RhinoDevel/cbmtapepi/docs/CBM Tape Pi - Raspberry Pi GPIO connections.png

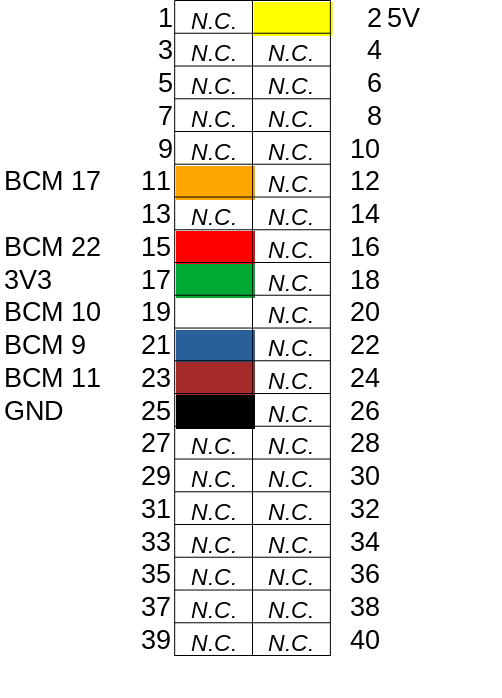
docs/CBM Tape Pi - Raspberry Pi GPIO connections.png
