RhinoDevel/cbmtapepi/docs/scope/CBM to Pi - MOTOR - fall (lower than 0_9V at Pi after 40us).png

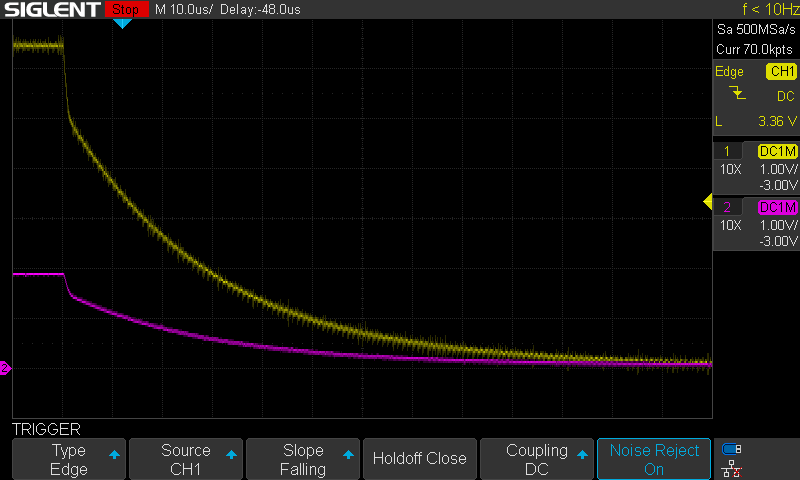
docs/scope/CBM to Pi - MOTOR - fall (lower than 0_9V at Pi after 40us).png
