RhinoDevel/cbmtapepi/docs/scope/CBM to Pi - MOTOR - rise (higher than 1_6V at Pi after 20us).png

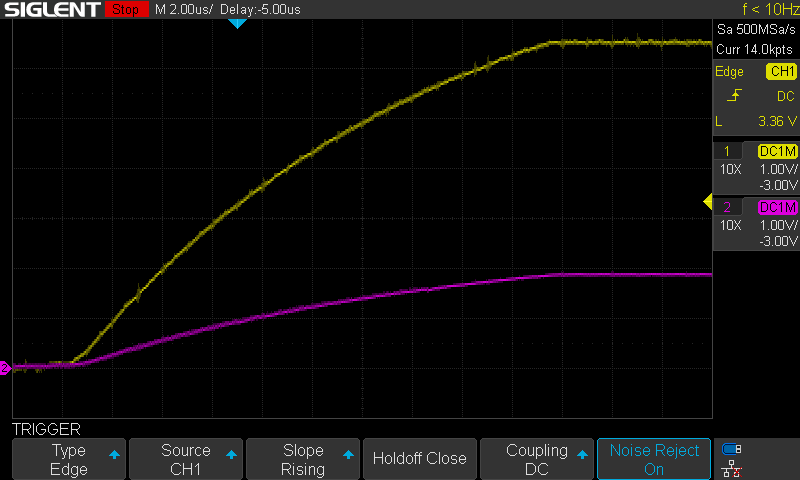
docs/scope/CBM to Pi - MOTOR - rise (higher than 1_6V at Pi after 20us).png
