RhinoDevel/cbmtapepi/docs/scope/CBM to Pi - WRITE - fall at CBM (higher than 1_6V at Pi after 2_5us.png

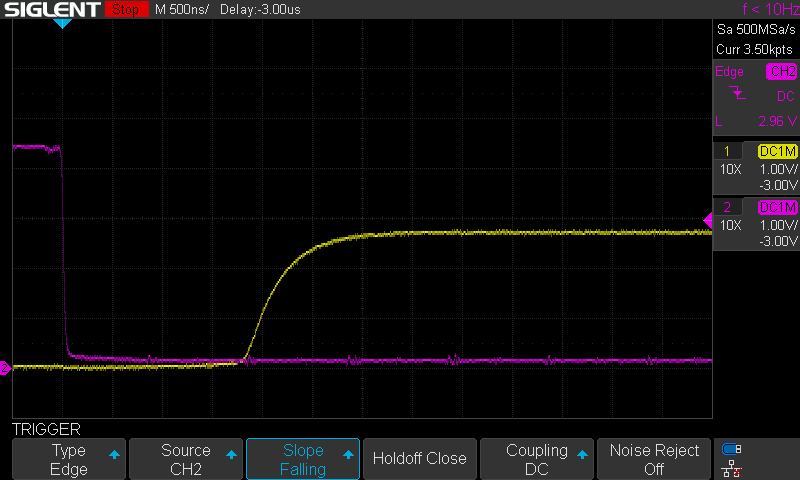
docs/scope/CBM to Pi - WRITE - fall at CBM (higher than 1_6V at Pi after 2_5us.png
