RhinoDevel/cbmtapepi/docs/scope/CBM to Pi - WRITE - rise at CBM (lower than 0_9V at Pi after 1us).png

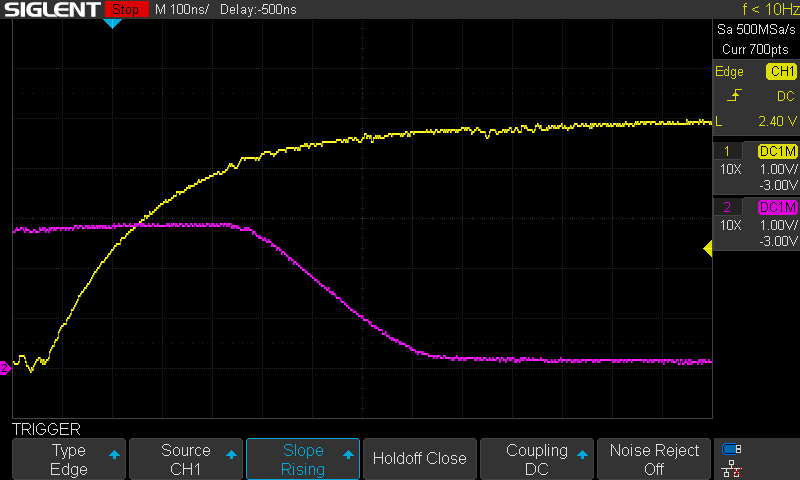
docs/scope/CBM to Pi - WRITE - rise at CBM (lower than 0_9V at Pi after 1us).png
