RhinoDevel/cbmtapepi/docs/scope/Pi to CBM - READ - rise at Pi (lower than 0_4V at CBM after 0_2us).png

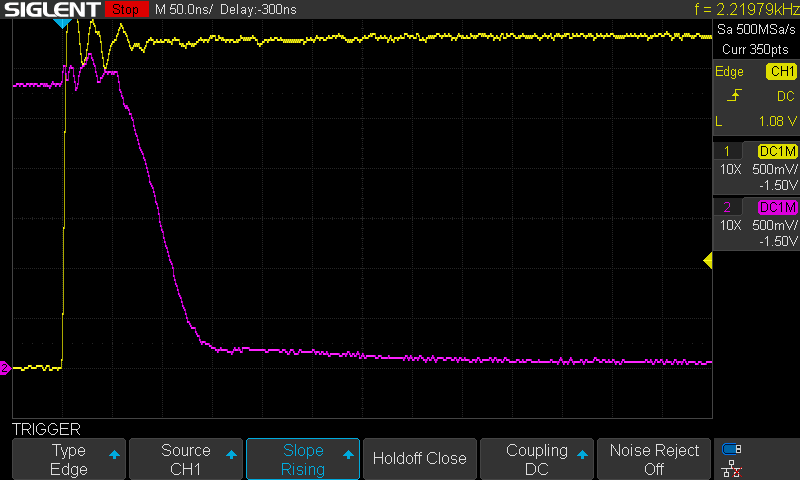
docs/scope/Pi to CBM - READ - rise at Pi (lower than 0_4V at CBM after 0_2us).png
