RhinoDevel/cbmtapepi/docs/scope/Pi to CBM - SENSE - fall at Pi (higher than 2V at CBM after 3us).png

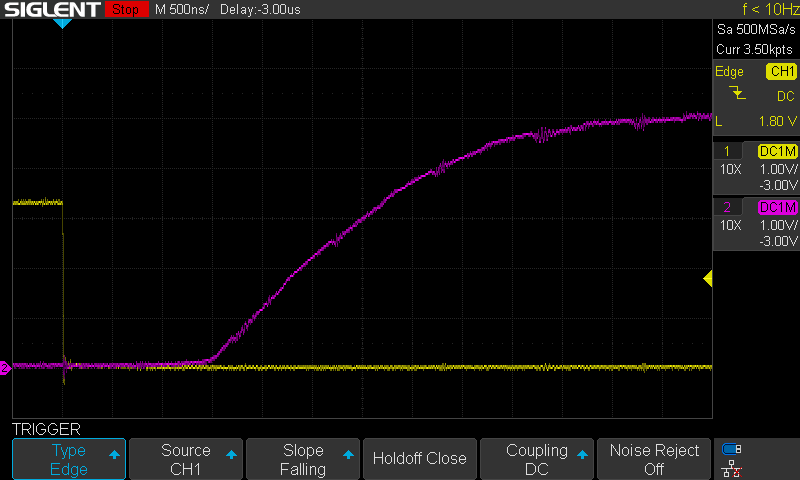
docs/scope/Pi to CBM - SENSE - fall at Pi (higher than 2V at CBM after 3us).png
