RhinoDevel/cbmtapepi/docs/scope/Pi to CBM - SENSE - rise at Pi (lower than 0_4V at CBM after 0_1us).png

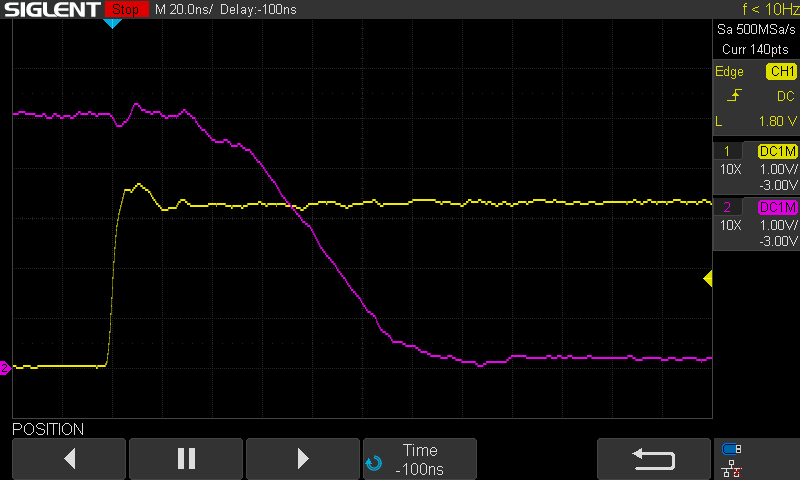
docs/scope/Pi to CBM - SENSE - rise at Pi (lower than 0_4V at CBM after 0_1us).png
