RhinoDevel/cbmtapepi/docs/simulation/CBM 2 Pi - MOTOR.png

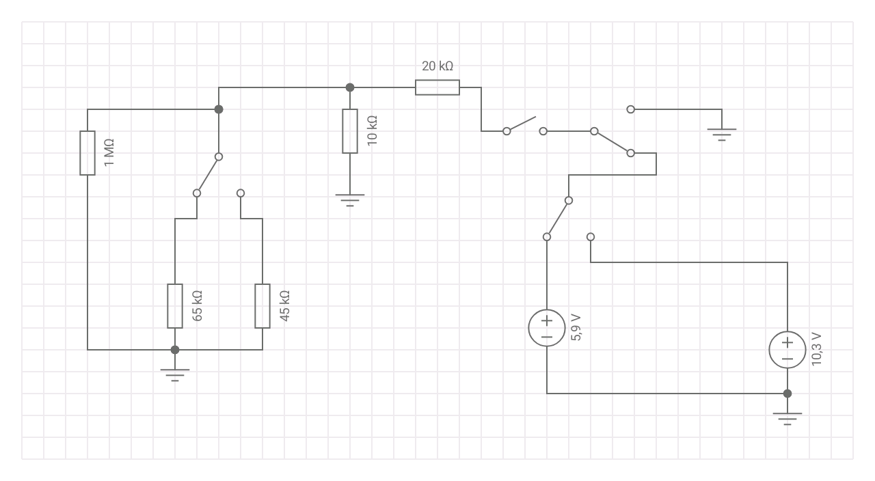
docs/simulation/CBM 2 Pi - MOTOR.png
