RhinoDevel/cbmtapepi/docs/simulation/CBM 2 Pi - WRITE inverting.png

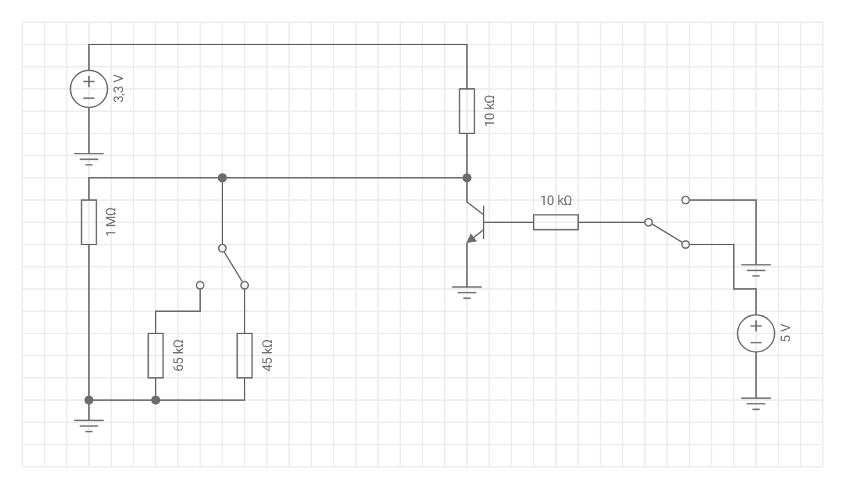
docs/simulation/CBM 2 Pi - WRITE inverting.png
