RhinoDevel/cbmtapepi/docs/simulation/Pi 2 CBM - READ inverting.png

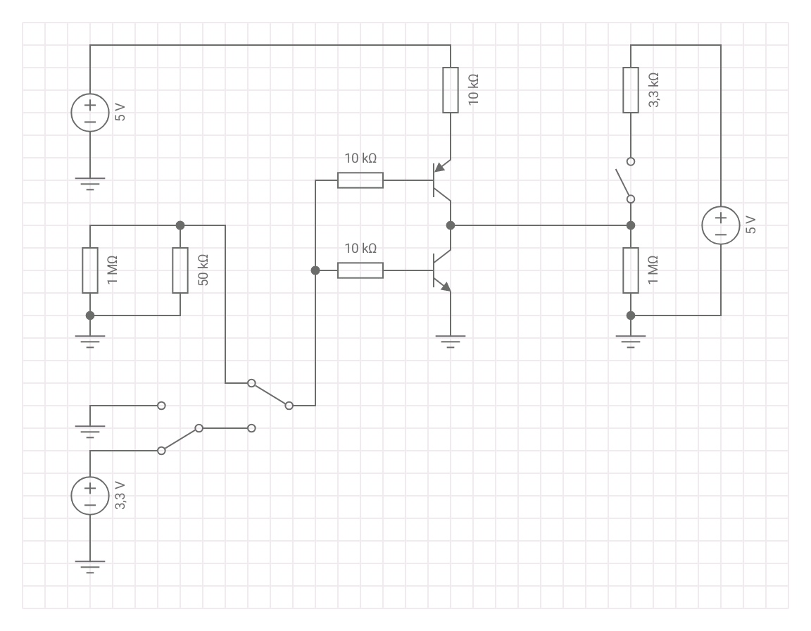
docs/simulation/Pi 2 CBM - READ inverting.png
