RhinoDevel/cbmtapepi/docs/simulation/Pi 2 CBM - SENSE inverting.png

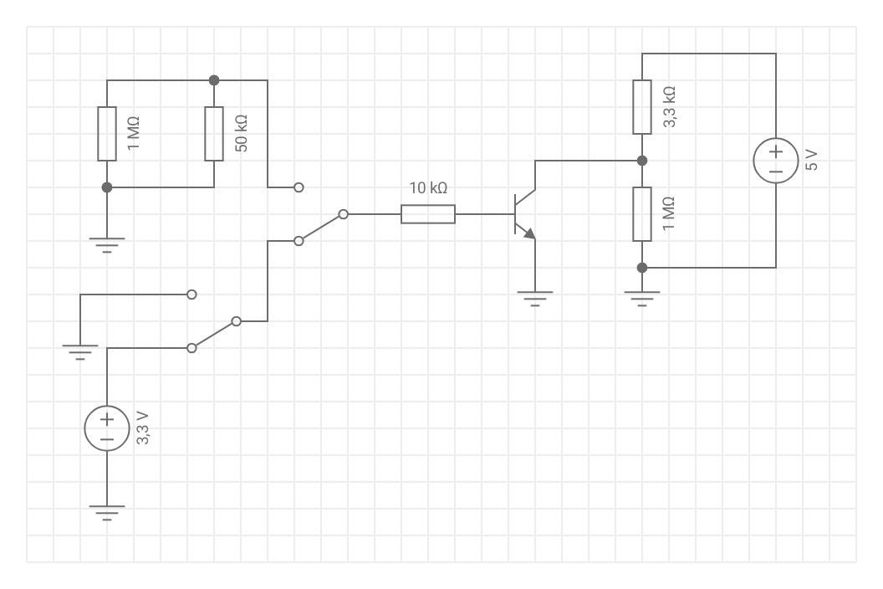
docs/simulation/Pi 2 CBM - SENSE inverting.png
