RhinoDevel/cbmtapepi/(threads)

Thread 1 (2021-05-05):

Details on Fastload protocol

picontrolit, 2021-05-05:
Hello RhinoDevel,
it would be great if you could share some details on the fastload protocol.
I am currently using a DIY (Arduino based) Tapuino "datasette".
A fastmode for it would be fantastic.
BR,
Alex

RhinoDevel, 2021-05-05:
Hi Alex,

the details are available in the code:

- [cbm](https://github.com/RhinoDevel/cbmtapepi/tree/master/cbm) holds the Commodore client code.
- [app/petload](https://github.com/RhinoDevel/cbmtapepi/tree/master/app/petload) the Pi server code.

Also take a look at the file [protocol.txt](https://github.com/RhinoDevel/cbmtapepi/blob/master/docs/protocol.txt), but beware, it is in a _work-in-progress_ state.

The protocol currently "handshakes" every bit, this is why the fast mode's rate is around 2.5kByte/s, only (still much faster than tape).

The implementation is specific to the way the datassette port connections are used (MOTOR, READ, WRITE, SENSE), see [connecting circuit](https://github.com/RhinoDevel/cbmtapepi/blob/master/docs/CBM%20tape%20to%20Raspberry%20Pi%20(Marcel%20Timm%2C%20RhinoDevel).png).

I do not know if/how this is applicable to Tapuino as I do not know how Tapuino works / what it can do.

picontrolit, 2021-05-05:
Many thanks. For the Tapuino I followed http://sweetlilmre.blogspot.com/2014/07/tapuino-20-c64-tape-emulator.html
It works like a charm (using tap files) but the speed is dead slow.

RhinoDevel, 2021-05-05:
> Many thanks. For the Tapuino I followed http://sweetlilmre.blogspot.com/2014/07/tapuino-20-c64-tape-emulator.html
> It works like a charm (using tap files) but the speed is dead slow.

CBM Tape Pi's fast mode would work with "default" (Commodore format) TAP files,
but not with TAP files using a custom format (tape fast loaders, copy protection stuff, etc.).
I am pretty sure that would be true for a fast mode added to Tapuino, too.

What I would like to do is porting CBM Tape Pi to Arduino, but there are no concrete plans.

Closed 2021-05-05.

Thread 2 (2021-05-10):

Some feature requests/wishes

picontrolit, 2021-05-10:
Feature requests:

1.	Use „-“  to delete files (instead or in parallel to “rm ...”)
2.	Soft reset of the PI via command from CBM (e.g. !resetPI)
3.	support loading/saving of PRG/TAP files on USB stick

RhinoDevel, 2021-05-10:
>     1. Use „-“  to delete files (instead or in parallel to “rm ...”)

This increases the risk of accidentally deleting files.
Do you have a specific use case in mind where the usefulness of the shorter command outweights that?

>     2. Soft reset of the PI via command from CBM (e.g. !resetPI)

On which occasion would that be useful?
I can think of changing the mode, only (because that currently needs a reset).
If the Pi would no longer react to commands (crashed), it would not react to that command, either.

>     3. support loading/saving of PRG/TAP files on USB stick

Thank you, I will add that to the to-do list in the readme.

picontrolit, 2021-05-12:
Hello RhinoDevel,
first of all: thanks a ton for this nice project. I finally got it running on my good old RPi 1.
Wrt my proposals:
1. I thought using the - would complement better with the + used for saving files
2. As the reset is more or less a one time event I dont think a soft reset is necessary to be implemented

After using it now for the first time: I would suggest to have an empty default folder to be used for storing prg files. I was surprised to see the root folder contents when I first used the !$ command.
Alex

RhinoDevel, 2021-05-14:
> first of all: thanks a ton for this nice project. I finally got it running on my good old RPi 1.

Thank you for trying it out! I am happy to hear that it works for you. Which Commodore are you using?

>     1. I thought using the - would complement better with the + used for saving files

Yes, I understand, this would make sense.

> After using it now for the first time: I would suggest to have an empty default folder to be used for storing prg files. I was surprised to see the root folder contents when I first used the !$ command.

Not a bad idea. In addition, a "create folder" command would be great.

Thanks for your suggestions!

picontrolit, 2021-05-15:
> Thank you for trying it out! I am happy to hear that it works for you. Which Commodore are you using?
I am using it with my CBM 8032-32B.

RhinoDevel, 2021-05-16:
> > Thank you for trying it out! I am happy to hear that it works for you. Which Commodore are you using?
>
> I am using it with my CBM 8032-32B.

Awesome! The main reason for developing CBM Tape Pi (fun and learning experience aside) is to target the CBM/PETs.

RhinoDevel, 2024-02-02:
Currently working on Linux port. Stuff like accessing files on USB stick and even internet access is in reach!

Thread 3 (2021-05-17):

10 kOhm resistor R1 (for the LED)

picontrolit, 2021-05-17:
The 10kOhm is too much for R1 (you can hardly see it).
A typical value for driving a LED is rather 150..500 Ohm.

RhinoDevel, 2021-05-17:
Added a hint (my LED is bright enough, but you are right): https://github.com/RhinoDevel/cbmtapepi/commit/23c164f6923c37bef1d5db48838063c12cadaf4e

Closed 2021-05-17.

Thread 4 (2021-06-06):

How to switch off fast mode?

picontrolit, 2021-06-06:
Hello,
I am missing an example in the README.md on how to turn off fast mode. Looking at the code, it should be mode="save".
So it is "!mode save" or is it SAVE"MODE SAVE"?
Alex

RhinoDevel, 2021-06-08:
The information is already included in the current [README](https://github.com/RhinoDevel/cbmtapepi/blob/master/README.md).

picontrolit, 2021-06-11:
I don't think so. The list of supported modes does not mention a mode to switch back to compatibility mode.

RhinoDevel, 2021-06-14:
You are right.

Here are the changes: https://github.com/RhinoDevel/cbmtapepi/commit/5f4da5128658016e82d8df5ac29be4d76dbe3580

Thanks.

By the way: Don't hesitate to create a pull request next time.

Closed 2021-06-08.

Thread 5 (2021-11-01):

External ACT LED

picontrolit, 2021-11-01:
I would like to place the CBM Tape Pi into a case. With that I can no longer see the ACT LED blinking. Can this be reconfigured to a GPIO pin?

Thread 6 (2021-12-28):

HW possible review?

dr-prodigy, 2021-12-28:
Hi, first of all, congrats for your great project! 👍
I was wondering: would it be feasible/correct to replace the 4 transistors with a Bi-Directional Logic Level Converter such as this one
https://www.adafruit.com/product/757
therefore simplifying the circuit further, and (most probably) protect both sides from wrong voltages (I'm thinking both about inadventent I/O toggles, and C64 & Pi power on/offs)?

Thank you very much, and KUTGW! 👍

RhinoDevel, 2021-12-29:
@dr-prodigy Thanks for the nice words!

About your question:

Using logic level converters may be possible for at least some of the connections, but I cannot answer that question without further investigation.

CBM Tape Pi is not just for the C64 and therefore the circuit must also work with other Commodore machines (currently VIC 20 and PET series) whose internal datassette circuitry is slightly different.
E.g. some computers have internal pull-up resistors attached to the SENSE and READ line (or inside the connected ICs like 6520, 6522 or 6526) and others not.
This is (for example) the reason, why BCM10 and READ are connected with the two-transistor combination.

The current interfacing circuit works for the supported machines and I thought a lot about it (and tested a lot) to let it be as safe as possible while using the simplest discrete components, only.

By the way: Powering the Commodore and Pi on/off in another order than described in the README should cause no harm, it is just not "officially recommended".

dr-prodigy, 2022-01-07:
Hi @RhinoDevel
sorry for the belated answer, and thank you very much again: very interesting answer!

Your explanation provides a lot more light on what, in my (limited) electronics understanding, I could see from the analysis of your schemes: the 2-transistor was in fact one on my biggest doubts.

My worry was mainly regarding the powering sequence and the possibility of harming my (beloved) c64; if there is no real risk on that side (although I will avoid stress on the hw anyway, I'm glad to hear that I can sometimes "forget" the exact order), I completely like your neat design: extremely convenient, easy and cheap.

I will soon prepare my CBMTapePi: thanks for your great work, I really appreciate it!
Cheers
dr-p

Closed 2022-01-07.

Thread 8 (2025-01-16):

Mention Need to Edit hardware/peribase.h When Building

jefftranter, 2025-01-16:
Thanks for creating this. The native Linux version is working well for me.

There is one step in building the code that might not be obvious - you need to edit hardware/peribase.h and uncomment the line corresponding to the model of Raspberry Pi you are building for. I think it would be worth mentioning this in the linux/README,md file.

RhinoDevel, 2025-01-17:
Thanks for your feedback! Pretty awesome that you got the Linux version running as it is still a development version.. Next step for me would be reducing the usage of the root access to a minimum, more testing and creating an official Linux release. I let it slide as there did not seem to be much interest in the project.. May I ask which Commodore(s) you have successfully used the Linux version with?

jefftranter, 2025-01-17:
I am using it on a Commodore 64 with a Raspberry Pi 3.

I do have the issue that the system hangs when I initially run the wedge so I have to interrupt the cbmtapepi program before and then restart it again in fast mode. The workaround with the dtoverlay command does not work for me.

After building the circuit on a solderless breaboard I made a more permanent setup on a prototype board. I plan to make a short YouTube video demonstrating it working.

RhinoDevel, 2025-01-23:
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

Sounds great!

I am planning to showcase some CBM Tape Pi builds here. If you don't mind, I would be happy about some pictures of (both of your) setups!

jefftranter, 2025-01-27:
Attached are some images of my breadboard and soldered versions.

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

RhinoDevel, 2025-02-05:
> Attached are some images of my breadboard and soldered versions.
>
> ...

Thank you very much for the pictures!

Makes me happy to see more/other incarnations of the CBM Tape Pi circuit.

And what a beautiful 1702 (if I am not mistaken..)!

Closed 2025-01-17.
