RhinoDevel/cbmtapepi/linux/dma/dma_gpio/dma_gpio_func.h

// Marcel Timm, RhinoDevel, 2021oct24

#ifndef MT_DMA_GPIO_FUNC
#define MT_DMA_GPIO_FUNC

// GPIO pin functions:
//
enum dma_gpio_func
{
    dma_gpio_func_input = 0,
    dma_gpio_func_output = 1,
    dma_gpio_func_alt0 = 4,
    dma_gpio_func_alt3 = 7,
    dma_gpio_func_alt5 = 2
    // ...
};

#endif //MT_DMA_GPIO_FUNC
