RhinoDevel/cbmtapepi/app/cmd/cmd.c

// Marcel Timm, RhinoDevel, 2019dec03

#include "cmd.h"
#include "../config.h"
#include "../mode/mode_type.h"
#include "../tape/tape_input.h"
#include "../../lib/assert.h"
#include "../../lib/alloc/alloc.h"
#include "../../lib/str/str.h"
#include "../../lib/filesys/filesys.h"
#include "../../lib/dir/dir.h"
#include "../../lib/basic/basic.h"
#include "../../lib/basic/basic_addr.h"
#include "../../lib/mem/mem.h"
#ifdef MT_LINUX
    #include <string.h>
#endif //MT_LINUX

#ifndef NDEBUG
    #include "../../lib/console/console.h"
#endif //NDEBUG

#ifndef MT_LINUX // No YMODEM support for Linux.
    #ifndef NDEBUG
        // For load via YMODEM command:
        //
        #include "../../lib/ymodem/ymodem.h"
        #include "../../lib/ymodem/ymodem_receive_params.h"
        #include "../../lib/ymodem/ymodem_receive_err.h"
        #include "../../hardware/armtimer/armtimer.h"
        #include "../../hardware/miniuart/miniuart.h"
    #endif //NDEBUG
#endif //MT_LINUX

#include <stdbool.h>

// - 16 characters available
// - File system support (by choice) limited to 8.3 format.
// => 16 - 8 - 1 - 3 = 4 characters available for commands.
//
//                                 "   thegreat.prg "
#ifndef MT_LINUX // No mode change support for Linux.
    static char const * const s_mode = "mode ";
#endif //MT_LINUX
static char const * const s_dir  = "$"; // (no parameters)
static char const * const s_rm   = "rm ";
static char const * const s_save = "+"; // Actually save file (no space).
static char const * const s_cd   = "cd "; // Supports "..", too.
#ifndef MT_LINUX // No YMODEM support for Linux.
    #ifndef NDEBUG
        static char const * const s_load_ymodem = "y*";
    #endif //NDEBUG
#endif //MT_LINUX
// static char const * const s_md   =    "md "; // Create a directory.
// static char const * const s_cp   =    "cp "; // Outp. file name by Pi.
// static char const * const s_mv   =    "mv "; // New file name by Pi.
//
// Anything else. => Load file.

static bool (*s_save_mode)(char const * const) = 0; // Stays NULL in Linux.
//
// Initialized by cmd_reinit().

static char * s_cur_dir_path = 0;
//
// Initialized by cmd_reinit(). Changed by exec_cd().

static struct dir_entry * * create_dir_entry_arr(int * const entry_count)
{
    struct dir_entry * * ret_val = 0;

    *entry_count = -1;

    filesys_remount();
    dir_reinit(s_cur_dir_path);

    ret_val = dir_create_entry_arr(entry_count);

    dir_deinit();
    filesys_unmount();

    return ret_val;
}

static struct cmd_output * exec_dir(enum mode_type const mode)
{
    struct cmd_output * ret_val = alloc_alloc(sizeof *ret_val);
    int entry_count = -1;
    struct dir_entry * * entry_arr = create_dir_entry_arr(&entry_count);
    int name_count = 1 + entry_count;
    char * * name_arr = alloc_alloc(name_count * sizeof *name_arr);

    name_arr[0] = str_create_concat(s_cur_dir_path, ":");
    for(int i = 1;i < name_count;++i)
    {
        name_arr[i] = str_create_concat(
            entry_arr[i - 1]->is_dir ? "DIR " : "    ",
            entry_arr[i - 1]->name);
    }

    dir_free_entry_arr(entry_arr, entry_count);
    entry_arr = 0;
    entry_count = -1;

    ret_val->name = str_create_copy("DIRECTORY");
    ret_val->bytes = basic_get_prints(

        // TODO: Don't do this in such a hard-coded way:
        //
        (mode == mode_type_c64tof || mode == mode_type_c64tom)
            ? MT_BASIC_ADDR_C64
            : (mode == mode_type_vic20tom
                ? MT_BASIC_ADDR_VIC
                : MT_BASIC_ADDR_PET),

        (char const * *)name_arr,
        name_count,
        MT_PETSCII_REPLACER,
        &(ret_val->count));

    for(int i = 0;i < name_count;++i)
    {
        alloc_free(name_arr[i]);
        name_arr[i] = 0;
    }
    alloc_free(name_arr);
    name_arr = 0;
    name_count = -1;

    return ret_val;
}

/**
 * - No support for deletion of empty subfolders.
 */
static bool exec_remove(char const * const command)
{
    char const * const name_only = command + str_get_len(s_rm);

    return filesys_remove(s_cur_dir_path, name_only);
}

#ifndef MT_LINUX // NO support for YMODEM in Linux.
#ifndef NDEBUG
    static struct cmd_output * exec_load_ymodem()
    {
        static uint32_t const len = 64 * 1024; // 64 kB.

        struct ymodem_receive_params p;
        enum ymodem_receive_err e;
        struct cmd_output * o = 0;

        // TODO: Hard-coded:
        //
        p.timer_start_one_mhz = armtimer_start_one_mhz;
        p.timer_get_tick = armtimer_get_tick;
        p.write_byte = miniuart_write_byte;
        p.read_byte = miniuart_read_byte;
        p.is_ready_to_read = miniuart_is_ready_to_read;
        p.is_stop_requested = 0;
        p.buf = alloc_alloc(len * sizeof (uint8_t));
        p.buf_len = len;
        p.file_len = 0;
        p.name[0] = '\0';

        console_writeline("exec_load_ymodem : Waiting for YMODEM sender..");
        e = ymodem_receive(&p);
        if(e != ymodem_receive_err_none)
        {
            // Debug output:
            //
            console_write("exec_load_ymodem : Failed to receive file (error ");
            console_write_dword_dec((uint32_t)e);
            console_writeline(")!");

            alloc_free(p.buf);
            p.buf = 0;
            return 0;
        }

        // Debug output:
        //
        console_write("exec_load_ymodem : Received file \"");
        console_write(p.name);
        console_write("\" with a length of ");
        console_write_dword_dec(p.file_len);
        console_writeline(" byte(-s).");

        o = alloc_alloc(sizeof *o);

        o->name  = str_create_copy(p.name);
        o->count = p.file_len;
        o->bytes = p.buf;
        return o;
    }
#endif //NDEBUG
#endif //MT_LINUX

static struct cmd_output * exec_load(char const * const command)
{
#ifndef NDEBUG
    console_write("exec_load: Trying to load file from command \"");
    console_write(command);
    console_writeline("\"..");
#endif
    struct cmd_output * const o = alloc_alloc(sizeof *o);

    o->bytes = filesys_load(s_cur_dir_path, command, &(o->count));
    if(o->bytes == 0)
    {
        alloc_free(o);
        return 0;
    }
    o->name = str_create_copy(command);
    return o;
}

static bool exec_cd(char const * const command)
{
    bool ret_val = false;
    char const * const name_only = command + str_get_len(s_cd);

    do
    {
        bool const is_back_cmd = str_are_equal(name_only, "..");
        char* buf = 0;

        if(is_back_cmd && str_are_equal(s_cur_dir_path, MT_FILESYS_ROOT))
        {
            break;
        }

        if(is_back_cmd)
        {
            int const last_slash_i = str_get_last_index(s_cur_dir_path, '/');

            assert(last_slash_i >= 0);

            buf = str_create_partial_copy(s_cur_dir_path, 0, last_slash_i + 1);

            if(!str_are_equal(buf, MT_FILESYS_ROOT))
            {
                buf[last_slash_i] = '\0'; // (minimal memory waste..)
            }
        }
        else
        {
            filesys_remount();
            dir_reinit(s_cur_dir_path);

            bool const has_sub_dir = dir_has_sub_dir(name_only);

            dir_deinit();
            filesys_unmount();

            if(!has_sub_dir)
            {
                break;
            }

            buf = dir_create_full_path(s_cur_dir_path, name_only);
        }

        alloc_free(s_cur_dir_path);
        s_cur_dir_path = buf;
        buf = 0;
        ret_val = true;
    }while(false);

#ifndef NDEBUG
    if(ret_val)
    {
        console_write("cmd/exec_cd : Changed to \"");
        console_write(s_cur_dir_path);
        console_writeline("\".");
    }
    else
    {
        console_write("cmd/exec_cd : Failed to change to \"");
        console_write(name_only);
        console_write("\" from \"");
        console_write(s_cur_dir_path);
        console_writeline("\".");
    }
#endif //NDEBUG

    return ret_val;
}

#ifndef MT_LINUX // No mode change support in Linux.
    static bool exec_mode(char const * const command)
    {
        char const * const name_only = command + str_get_len(s_mode);
        bool const ret_val = s_save_mode(name_only);

    #ifndef NDEBUG
        if(ret_val)
        {
            console_write("cmd/exec_mode : Changed mode to \"");
            console_write(name_only);
            console_writeline("\".");
        }
        else
        {
            console_write("cmd/exec_mode : Failed to change mode to \"");
            console_write(name_only);
            console_writeline("\".");
        }
    #endif //NDEBUG

        return ret_val;
    }
#endif //MT_LINUX

static bool exec_save(
    char const * const command, struct tape_input const * const ti)
{
    char const * const name_only = command + str_get_len(s_save);

    // Using (kind of overdone) buffer to be able to use file system singleton:

    uint32_t const full_byte_count = (uint32_t)(2 + ti->len);
    uint8_t * const bytes = alloc_alloc(
            full_byte_count * (uint32_t)(sizeof (uint8_t)));
    int byte_pos = 0;

    bytes[byte_pos++] = (uint8_t)(ti->addr & 0x00FF);
    bytes[byte_pos++] = (uint8_t)(ti->addr >> 8);
    assert(byte_pos == 2);
    memcpy(bytes + byte_pos, ti->bytes, (size_t)ti->len);

    bool const ret_val = filesys_save(
        s_cur_dir_path, name_only,
        bytes, full_byte_count,
        false); // No overwrite.

    alloc_free(bytes);
    return ret_val;
}

bool cmd_exec(
    enum mode_type const mode,
    char const * const command,
    struct tape_input const * const ti,
    struct cmd_output * * const output)
{
    *output = 0;

    if(s_cur_dir_path == 0)
    {
        return false;
    }

#ifndef MT_LINUX // You cannot switch the mode in Linux.
    if(str_starts_with(command, s_mode))
    {
        return exec_mode(command);
    }
#endif //MT_LINUX
    if(str_starts_with(command, s_dir))
    {
        *output = exec_dir(mode);
        return true;
    }
    if(str_starts_with(command, s_rm))
    {
        return exec_remove(command);
    }
    if(str_starts_with(command, s_cd))
    {
        return exec_cd(command);
    }
    if(str_starts_with(command, s_save))
    {
        return exec_save(command, ti);
    }

#ifndef MT_LINUX // No YMODEM support in Linux.
    #ifndef NDEBUG
        if(str_starts_with(command, s_load_ymodem))
        {
            *output = exec_load_ymodem();
            return *output != 0;
        }
    #endif //NDEBUG
#endif //MT_LINUX
    *output = exec_load(command);
    return *output != 0;
}

void cmd_reinit(
    bool (*save_mode)(char const * const),
    char const * const start_dir_path)
{
#ifdef MT_LINUX // Mode change not supported in Linux.
    assert(save_mode == 0);
#endif //MT_LINUX
    s_save_mode = save_mode;

    if(s_cur_dir_path != 0)
    {
        alloc_free(s_cur_dir_path);
        s_cur_dir_path = 0;
    }
    s_cur_dir_path = str_create_copy(start_dir_path);
}

void cmd_free_output(struct cmd_output * const output)
{
    if(output == 0)
    {
        return; // Nothing to do.
    }

    alloc_free(output->name);
    output->name = 0;

    alloc_free(output->bytes);
    output->bytes = 0;

    output->count = 0;

    alloc_free(output);
}
