RhinoDevel/cbmtapepi/app/petload/petload_prg_name.h

// Marcel Timm, RhinoDevel, 2024feb03

#ifndef MT_PETLOAD_PRG_NAME
#define MT_PETLOAD_PRG_NAME

//                                   "1234567890123456"
#define MT_PETLOAD_PRG_NAME_TAPE_BUF "FASTMODE: SYS655"

//                              "1234567890123456"
#define MT_PETLOAD_PRG_NAME_RUN "FASTMODE: RUN   "

#endif //MT_PETLOAD_PRG_NAME
