RhinoDevel/cbmtapepi/app/tape/tape_defines.h

// Marcel Timm, RhinoDevel, 2019sep15

#ifndef MT_TAPE_DEFINES
#define MT_TAPE_DEFINES

#define MT_HEADERDATABLOCK_LEN 4852
//
// HARD-CODED: This depends on tape_fill_buf()!

#endif  //MT_TAPE_DEFINES
