RhinoDevel/cbmtapepi/app/tape/tape_sample_type.h

// Marcel Timm, RhinoDevel, 2018dec12

#ifndef MT_TAPE_SAMPLE_TYPE
#define MT_TAPE_SAMPLE_TYPE

#ifdef __cplusplus
extern "C" {
#endif

enum tape_sample_type
{
    tape_sample_type_pet = 1,
    tape_sample_type_c64 = 2
};

#ifdef __cplusplus
}
#endif

#endif //MT_TAPE_SAMPLE_TYPE
