RhinoDevel/cbmtapepi/app/ui/ui_commodore_to_terminal.h

// Marcel Timm, RhinoDevel, 2019jul16

#ifndef MT_UI_COMMODORE_TO_TERMINAL
#define MT_UI_COMMODORE_TO_TERMINAL

#include <stdbool.h>

#include "../tape/tape_input.h"

bool ui_commodore_to_terminal(bool const interactive);

#endif //MT_UI_COMMODORE_TO_TERMINAL
