RhinoDevel/cbmtapepi/app/ui/ui_terminal_to_commodore.h

// Marcel Timm, RhinoDevel, 2018dec24

#ifndef MT_UI_TERMINAL_TO_COMMODORE
#define MT_UI_TERMINAL_TO_COMMODORE

#include <stdbool.h>

bool ui_terminal_to_commodore(bool const interactive);

#endif //MT_UI_TERMINAL_TO_COMMODORE
