RhinoDevel/cbmtapepi/(commit log)

2018-01-17 Change to working/enabled Raspi1 sample (serial out and blinking); Add NON-WORKING UART0 serial out sample.
2018-01-17 ARM timer experiment.
2018-01-24 Move ARM Timer stuff to own "lib".
2018-01-24 Replace delay() with busy wait library function.
    [kernel_main.c]
2018-10-20 Add unused tape sample files.
2018-10-21 Commented-out tape read sample.
2018-10-21 Add missing DONE symbol.
    [tape_fill_buf.c]
2018-10-22 Fix bug in countdown generation.
    [tape_fill_buf.c]
2018-10-23 BUGFIX: Correct end address plus one value.
    [tape_fill_buf.c]
2018-10-23 Temporarily add 5 second pause between header and content data to let the user press a key for loading of content (should be replaced by motor line on/off detection).
    [tape_fill_buf.c, tape_symbol.h, tape_transfer_buf.c]
2018-10-25 Replace some hard-coded stuff.
    [tape_input.h, tape_sample.c]
2018-10-26 "Fix" LED flashing and add countdown.
    [kernel_main.c]
2018-10-26 BUGFIX: Minus sign gone bad..
    [tape_sample.c]
2018-10-26 Enable/fix sample for PET and remove wrong comment.
    [tape_sample.c]
2018-11-01 Switch to C64 code being enabled; Comment about file to byte array via xxd command.
2018-11-01 Replace some magic numbers; Add motor line usage (for pause); Remove some debug code.
    [kernel_main.c, tape_transfer_buf.c, tape_transfer_buf.h]
2018-11-01 Re-enable PET sample and fix wrong address.
    [tape_sample.c]
2018-11-01 Fix wrong order of parameters.
    [kernel_main.c]
2018-11-01 Replace pause symbol with motor line waiting.
    [tape_fill_buf.c, tape_transfer_buf.c]
2018-11-05 Trigger stopping of transfer interpreted as successful by motor signal getting LOW after header data transfer.
2018-11-13 UART0 / PL011UART implementation (not 100% perfect); Add missing files to clear script.
    [kernel_main.c, pl011uart.c, pl011uart.h]
2018-11-16 UI (main menu and dummy send menu); Remove/replace single tape header to use; Reorganized tape sending and samples.
    [tape_send.c, tape_send.h, tape_send_params.h, ui.c, ui_send_sample.c]
2018-11-16 Use new structures to send; Commented-out way to check default UART0 Baud rate.
2018-12-11 (Currently fake) assert() macro.
2018-12-11 Replace mtalloc submodule with customized copy and use dynamic memory allocation.
    [config.h, kernel_main.c, mem.c, mem.h]
2018-12-11 At least show a generic error message, if an assertion failed (REQUIRES INITIALIZED CONSOLE!).
    [assert.h]
2018-12-16 Watchdog timer.
2018-12-16 Sending samples implementation and back key support.
2018-12-16 BUGFIX: Actually send C64 sample for C64 and NOT PET sample..
    [ui_send_sample.c]
2018-12-16 Enable internal pull-down resistor for motor line.
2018-12-16 BUGFIX: Allocate correct amount of memory for data.
    [tape_sample.c]
2018-12-16 Show LOAD hint message, before starting sample sending.
2018-12-18 Some UART helper functions.
2018-12-18 Renaming (to avoid files and stuff with same name).
    [mem.h]
2018-12-24 "Return" real payload length (based on SUB char); No longer write SUB characters to buffer; Commented-out debug printing.
2018-12-29 Comment about how to configure and send via USB serial adapter to Raspberry Pi via XMODEM with Linux.
2019-01-07 Send file name in upper case letters to Commodore.
2019-01-13 Wiring picture (Qucs).
    [Serial to CBM tape via Raspberry Pi (Marcel Timm, RhinoDevel).sch]
2019-01-13 Wiring diagram, send example, improvements.
2019-01-14 Photo of connected Raspberry Pi 1.
2019-07-11 Write pin setup (unused).
2019-07-13 Reduce timeout; Add error handling; Return true, if OK.
    [tape_receive_buf.c]
2019-07-14 Bugfix: Use OR instead of AND; Comments; extract_headerdatablock() completed.
    [tape_extract_buf.c]
2019-07-14 Length error check in extract_contentdatablock().
    [tape_extract_buf.c]
2019-07-14 Bugfixes and (debug) output. SEEMS TO WORK, YEAH!!!
    [kernel_main.c, tape_extract_buf.c]
2019-07-26 BUGFIXes (unfinished) and DEBUG code.
    [ui_send_test.c]
2019-08-03 Do not restart ARM timer's free running counter, if already running.
2019-08-03 baregpio: Replace busywait_clockcycles(150) with armtimer_busywait_microseconds(1).
    [baregpio.c]
2019-08-03 transfer_pulse(): Replace busywait_microseconds() with armtimer_busywait_microseconds().
    [tape_send_buf.c]
2019-08-04 FEATURE: Toggle between LOAD and SAVE via button and LED.
2019-08-06 BUGFIX: Write a lot of stuff to console when debug mode is enabled, only.
    [assert.h, statetoggle.c, tape_extract_buf.c, tape_init.c, tape_receive.c, tape_receive_buf.c, tape_send.c, tape_send_buf.c]
2019-08-07 UART implementations: Flush receive FIFO after initialization.
2019-08-07 UARTs: Remove comments; Wait some time during/after initialization.
2019-08-08 BUGFIX: Do not shift by 16, but 4.
    [mailbox.c]
2019-08-11 FEATURE: Switch console output from MiniUART to video/framebuffer.
2019-08-21 Move ARM timer files to hardware folder.
2019-08-21 Move PL011 UART files to hardware folder.
2019-08-21 Fix path in comment.
    [config.h]
2019-08-21 Decouple text output, scrolling, etc. from framebuffer driver.
2019-08-24 Decouple Bare GPIO driver from bare metal dependencies.
2019-08-25 Replace ARM timer usage with initialization functions for tape.
    [kernel_main.c, tape_init.c, tape_init.h, tape_receive_buf.c, tape_receive_buf.h, tape_send_buf.c, tape_send_buf.h]
2019-08-26 Check for sleep error.
    [main.c]
2019-08-27 Add documentation of Raspberry Pi GPIO connections.
    [CBM Tape Pi - Raspberry Pi GPIO connections.ods]
2019-08-27 Documentation of Commodore machine cassette port connections.
    [CBM Tape Pi - Commodore machine cassette port connections.ods]
2019-08-28 Update schematic with SAVE support.
    [Serial to CBM tape via Raspberry Pi (Marcel Timm, RhinoDevel).sch]
2019-08-28 Add push button and status LED to schematic.
    [Serial to CBM tape via Raspberry Pi (Marcel Timm, RhinoDevel).sch]
2019-08-30 BUGFIX: Don't crash, if receive_from_commodore() failed; Add return value.
    [ui_commodore_to_terminal.c, ui_commodore_to_terminal.h]
2019-08-30 Disable video (does not work on Raspi 2, yet); Add status LED flashing on mode startups.
    [kernel_main.c]
2019-08-30 Mode toggle LED flash hint and update to v1.5.1.
2019-09-03 CURRENTLY NOT WORKING FOR Raspi 2! Interrupts; Busy-wait tool is back.
    [kernel_main.c]
2019-09-03 Add system timer.
2019-09-03 Enable ACT LED support for Raspi 2.
2019-09-04 Replace mmio_... with mem_...
    [sdcard.c]
2019-09-04 Comment-out missing includes; Replace waitMicro() with own function.
    [sdcard.c]
2019-09-04 Comment-out printf() usage.
2019-09-05 BUGFIX: Timeout in sdAppSendOpCond(); Debug code; Cosmetic stuff.
    [sdcard.c, sdcard.h]
2019-09-06 Remove some unused stuff; Refactor reset_card().
    [sdcard.c]
2019-09-06 Remove voltage switch comments.
2019-09-08 Double ARM timer interrupt frequency.
2019-09-14 Comment about BUG; Address conversion bugfix(?); Remove some debug output.
    [cbm_send.c, main.c]
2019-09-14 Debug print tape_input.
2019-09-14 Comment about BUG to fix.
    [main.c]
2019-09-15 BUGFIX: Prevent misaligned memory accesses (leads to errors on ARMv6).
    [config.h]
2019-10-26 BUGFIX: Ignore some initial sync pulses, because the first level changes detected as sync pulse may not be a sync pulse at all.
    [tape_receive_buf.c]
2019-11-02 Add (unaltered) FatFs R0.14.
    [mkfs.xlsx]
2019-11-27 Replace Petit FatFs with FatFs (for write support); Add debug file write test.
    [kernel_main.c]
2019-11-29 Add missing memory deallocation.
    [kernel_main.c]
2019-11-30 Commented out, but directory listing successfully send and printed on C64!
2019-12-01 Fix: Usage of tape_input_write().
    [tape_send.c]
2019-12-01 Fix (commented out) real saving; Add error "handling" (just for debugging).
    [kernel_main.c]
2019-12-02 Switch to "File system and SAVE control" instead of "YMODEM plus toggle button" mode.
2019-12-02 Fix stuff for release build.
    [kernel_main.c]
2019-12-03 Encapsulate mount/unmount.
2019-12-03 Bugfix: Add missing deinitializations.
    [cmd.c]
2019-12-05 PETSCII <-> ASCII replacer.
    [cbm_send.c]
2019-12-06 Universal (insertion) sort.
2019-12-07 Show, if folder or not; Fix memory leaks.
    [cmd.c]
2019-12-07 Move to sub folder; Fix lower/upper case bug.
    [cmd.c]
2019-12-07 SOME BUG EXISTS (cd)! Return result in exec_cd().
    [cmd.c]
2019-12-08 Bugfixes: Use full path.
    [cmd.c]
2019-12-08 Return false on error, if deletion failed; No support for subfolder deletion.
    [cmd.c]
2019-12-08 Blink LED on error (until next command was successful).
    [kernel_main.c]
2019-12-08 Fix warning leading to error during interactive compile.
    [kernel_main.c]
2019-12-11 Modify documents for v1.6.0.
    [CBM Tape Pi - Raspberry Pi GPIO connections.ods, CBM tape to Raspberry Pi (Marcel Timm, RhinoDevel.sch, Serial to CBM tape via Raspberry Pi (Marcel Timm, RhinoDevel).sch]
2019-12-11 Fix file names.
    [CBM tape to Raspberry Pi (Marcel Timm, RhinoDevel).sch]
2019-12-12 Commented-out code to switch from hypervisor to supervisor mode (for Raspberry Pi 2 and more recent).
2019-12-12 Move enabling interrupts to irqcontroller files; Add (commented-out) Pi 2 HYP to SVR mode toggle.
2019-12-12 BUGFIX: Make SD card work with other Pis than Pi 1; Disable debug output.
    [sdcard.c]
2019-12-13 Move IRQ/timer init further down; Add debug-mode SD card early initialization.
2019-12-14 Updated to v1.6.1.
    [CBM tape to Raspberry Pi (Marcel Timm, RhinoDevel).sch]
2019-12-17 Improve comments; Add sample data ("loader").
2019-12-17 "!pet2" to load fast loader into tape buffer (just sample PRG for now).
2019-12-31 Hardware BUGFIX: Replace motor line resistors to avoid too high influence of Pi GPIO internal impedance, but stay inside specs for motor voltage of 6.2V-7.8V, Pi GPIO pin input max. of 0.5mA (by 16k 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
    [CBM tape to Raspberry Pi (Marcel Timm, RhinoDevel).sch]
2020-01-04 BUGFIX: Byte retrieval now working.
    [petload.c]
2020-01-05 NOT WORKING (working on fast load after command was successfully send to Pi).
    [petload.c, petload.h]
2020-01-05 Still NOT WORKING. Debug code, bug fix.
    [petload.c]
2020-01-06 More untested modifications and fixes.
    [petload.c, petload.h]
2020-01-06 MOTOR line check and fix typo in comment.
    [petload.c, petload.h]
2020-01-06 MOTOR signal from default LOW to HIGH, then LOW (pulse); Other corrections.
    [petload.c, petload.h]
2020-01-06 Another bug fixed and debug code removed.
    [petload.c]
2020-01-10 Switch address & byte count order in petload_send(); Remove some debug code; Answer with "NOP" after executing commands without response.
2020-01-20 UNTESTED motor signal measurement results used.
2020-02-08 Save 5 bytes & reduce waiting for motor signal to ~100us.
2020-11-10 Fix motor delay constant and actually use it.
2020-11-22 Modified to fix sporadic bug (hang) during retrieval; Simplified for lesser/simpler PET code. MISSING: PET code!
    [petload.c, petload.h]
2020-11-28 BUGFIX: Used wrong GPIO pin; Adding (some commented-out) debug code and debug output.
    [petload.c]
2020-12-16 BUGFIX: Make fast loader work!
    [petload.c]
2020-12-18 BUGFIX: Let LED blink on command error, but send zeroes to CBM to get it out of "waiting" mode; Refactoring.
    [kernel_main.c]
2020-12-31 BUGFIX: Send fake bytes in release mode, too; Improve debug output.
    [petload.c]
2021-01-03 Add motor test source code file.
2021-01-08 CBM: Use tape header name for install hint to user; Use write line as is-installed signal; Commented-out 5 second delay loop (sample).
2021-01-09 FEATURE: Toggle to PET 4 fastmode and automatically start in fastmode loader mode; Remove/comment-out unused fastmode switch possibility; Add to-do comments.
2021-02-13 Update used GPIO pin nrs. (at least in source code).
2021-02-13 Modify code to be compatible to now inverting READ, SENSE and WRITE lines; Fix PET fast mode bug.
    [kernel_main.c, petload.c, tape_init.c, tape_receive.c, tape_receive_buf.c, tape_send.c, tape_send_buf.c]
2021-02-17 Add oscilloscope screenshots (for new connecting circuits).
2021-02-17 Add new connecting circuit simulations (includes new connecting circuit schematics).
2021-02-17 Modify motor rise and fall times slightly to match scope images.
2021-02-18 Update Raspberry Pi GPIO connections.
    [CBM Tape Pi - Raspberry Pi GPIO connections.ods]
2021-02-18 Update connection schematic.
    [CBM tape to Raspberry Pi (Marcel Timm, RhinoDevel).sch]
2021-02-20 Modified to be able to assemble for PET BASIC v2 and v4 (v1 support incomplete).
2021-02-21 Bugfix: Perform NEW on install of fast mode wedge to fix BASIC pointers; Fix a comment.
    [pet.asm]
2021-02-21 Don't toggle WRITE line after wedge install, but set it to HIGH; Fix comment.
    [pet.asm]
2021-02-21 Bugfix: WRITE line must be set to LOW at CBM, not high.
    [pet.asm]
2021-02-25 Simplify code a bit and correct at least one comment.
    [tape_receive_buf.c]
2021-02-25 Read via SAVE in compatibility mode: Double skip and sync count (not necessary); Wait for HIGH before waiting for LOW at two places (not necessary); Debug output and waiting to compensate (maybe nece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
    [tape_receive_buf.c]
2021-02-26 Some debug output in case of an error.
    [tape_extract_buf.c]
2021-02-26 Clean-up code; PET BASIC v1 support currently with source code change. Need to implement that to be dynamic.
2021-02-27 Remove assert not necessary; Improve comments; Fix bug from last commit.
    [tape_receive_buf.c]
2021-02-28 Bugfix: CHRGET and CHRGOT for PET BASIC v1.
    [pet.asm]
2021-03-06 Enable "termwili" (currently unused).
2021-03-06 Fix str usage for tom installation.; Comment-out (and "fix") debug stuff.
    [wedge.asm]
2021-03-13 BUGFIX: Compatibility mode now supports VIC 20 correctly (which uses the WRITE line for keyboard, too..).
    [tape_receive_buf.c]
2021-03-13 VIC 20 support implemented, but not working perfectly, yet.
    [kernel_main.c, petload.c, petload.h, petload_vic20tom.h]
2021-03-18 BUGFIX: Show directory content on VIC-20; Comment about "create folder" command to-be-implemented; Comment about existing bug, etc.
    [cmd.c, cmd.h, kernel_main.c]
2021-03-20 Temporarily enable video output on Raspberry Pi 1.
2021-03-20 Replace branching in IRQ handler with logic.
    [kernel_main.c]
2021-03-20 Replace mem_write() and mem_read() with preprocessor macros.
    [gpio.c, gpio_params.h, kernel_main.c, main.c]
2021-03-21 Replace function select 0 and get_fsel() with defines.
    [gpio.c]
2021-03-21 Replace two constants with defines.
    [gpio.c]
2021-03-21 Replace get_set() and get_clr() functions with macros.
    [gpio.c]
2021-03-21 Replace get_pin_mask() function with macro.
    [gpio.c]
2021-03-21 Replace get_lev() and s_offset_lev0 with defines.
    [gpio.c]
2021-03-21 Remove GPIO pin setup from ISR.
2021-03-21 Use system instead of ARM timer to simplify (and speed up) debug code.
2021-03-21 Move signal detection to ISR (works, but not "fast enough" - fix that!); Disable video output (again).
    [kernel_main.c]
2021-03-22 Wait 10 seconds (too long?) for user to power-on CBM before starting loop in fast mode.
    [kernel_main.c]
2021-03-26 Top of free highest memory install for C64 (needs a BUGFIX for str location); Fix typo.
    [00-make.asm, 03-topofree.asm, 04-install.asm]
2021-03-27 BUGFIX: Calculate TOM string buffer offset correctly.
    [03-topofmem.asm]
2021-03-27 Add comments and simplification to workaround bug(-s) in assembler..
    [00-make.asm, 03-topofree.asm]
2021-03-27 Update C64 TOM install (bugfix).
    [petload_c64tom.h]
2021-03-27 BUGFIX: Correct start of BASIC selection.
    [cmd.c]
2021-03-30 Debug code to measure time spent in a loop; Commented-out memory barrier stuff; Remove conditional branch from ISR; Improve (fix?) debug output calculation.
    [kernel_main.c]
2021-03-31 Raspberry Pi 2: Enable branch prediction, L1 data & instruction cache, enable DSB in ISR entry and return, enable "parking" of other CPU cores with wake-up (NEEDS TESTING), fix debug measuring, impro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
    [kernel_main.c]
2021-04-02 Make sure that signal measuring/detection enabled during fast loader being active, only (to avoid activity during SAVE).
    [kernel_main.c]
2021-04-03 New commented-out debug function; Comment; Move (not working) secondary cores init. below GPIO init.
    [kernel_main.c]
2021-04-03 Fix secondary cores start-up; Fix multicore test code.
    [kernel_main.c]
2021-04-05 Comments, cosmetics and removal of commented-out hard-coded way of switching from HYP to SVC.
2021-04-05 Make sure that "parked" secondary CPU cores can enter low-power state.
2021-04-05 BUGFIX: Re-enable ACT status blinking; Explicitly start ARM timer (1 MHz) during init.
    [kernel_main.c]
2021-04-06 FEATURE: Raspberry Pi 3 support!
2021-04-07 Improve ACT LED mentions.
2021-04-07 Enable ACT LED feature on Raspberry Pi Zero.
2021-04-07 Mention Raspberry Pi Zero in comment; Fix comment.
2021-04-08 Replace two to-dos with one comment.
    [kernel_main.c]
2021-04-08 BUGFIX: Use mailboxes correctly (read status from mailbox 1 before write); Renaming.
    [mailbox.c]
2021-04-08 Show core and ARM frequencies during boot-up in debug mode.
2021-04-08 Add comment (about timers); "Fix" Pi 3 build.
    [kernel_main.c]
2021-04-10 FEATURE: Blinking ACT LED on Raspberry Pi now working (via EVIL DIRTY HACK).
2021-04-11 BUGFIX: Typo caused LED to keep flashing under some circumstances; Improve comments.
    [kernel_main.c]
2021-04-16 Make it clear that SD card driver is hard-coded for 250MHz EMMC clock rate.
2021-04-16 mailbox_write_clockrate(); Re-enable assertions in mailbox code; Mailbox comments; Mailbox bugfixes.
    [mailbox.c, mailbox.h]
2021-04-16 Querying for VC firmware rev., board model & rev., ARM & VC mem., SoC temp.
2021-04-17 Fix in comment, cosmetic changes.
    [sdcard.c]
2021-04-18 BUGFIX: Add missing defines and array entries..
    [sdcard.c, sdcard_defines.h]
2021-05-11 Add hints about DMA usage & timer interrupt handler.
2021-05-11 Some code improvements in reset_card().
    [sdcard.c]
2021-05-11 Replace unsigned int with uint32_t.
    [sdcard.c]
2021-05-11 Replace support flags with simpler boolean values.
    [sdcard.c, sdcard_defines.h]
2021-05-12 Fix typo in comment.
    [sdcard_defines.h]
2021-05-17 Add note about optionally using a lower value LED series resistor.
2021-05-23 Initial Arduino code for ESP8266 (IRQ with status blinking, READ sample output).
2021-05-23 Initial MOTOR line configuration.
2021-05-23 Add Raspberry Pi GPIO specification values to compare.
2021-05-23 Rename file (to make Arduino IDE work..).
2021-05-27 Move from Arduino/ESP8266 to PlatformIO/Arduino/ESP8266.
2021-05-28 Using console (and calc) and sample code.
2021-05-31 Add own (simple..) assert.h to Arduino.
2021-06-14 Hints about switching back to compatibility mode & commands being the same in fast mode (although redundant).
2021-09-30 Add link to Sven Petersen's PCB layout as another alternative to using a breadboard.
2021-10-02 Replace done with explicit error pseudo-symbol and symbol count usage.
    [tape_extract_buf.c, tape_extract_buf.h, tape_fill_buf.c, tape_fill_buf.h, tape_receive.c, tape_receive_buf.c, tape_receive_buf.h, tape_send.c]
2021-10-06 Replace timer functions with dummy functions and asserts; Add to-do about using pigpio for sending.
    [main.c]
2021-10-06 pigpio helper files; Link with/for pigpio; (Sample) pigpio usage code; Remove/replace obsolete/non-working stuff.
    [main.c]
2021-10-10 UNTESTED bugfix of pigpio wave generation.
    [main.c]
2021-10-10 Use correct type for symbol and pulse counts.
    [main.c]
2021-10-10 Add doc. to calc. symbol count.
    [symbol_count.ods]
2021-10-12 Update to reflect current state of Linux port.
2021-10-12 Fix bugs. Necessary motor signal off reaction still not implemented.
    [main.c]
2021-10-13 Print newline after CTRL+C.
2021-10-14 Add C64 BASIC sample PRG.
2021-10-14 UNTESTED: Motor signal off/on support; Improve error handling.
    [main.c]
2021-10-14 Add missing stop signal handling.
    [main.c]
2021-10-14 Add initial motor wait.
2021-10-16 Fix content block calc.; Add PRG file as input.
    [symbol_count.ods]
2024-01-19 Add ESP32 and ESP8266 port(-s) as project goals.
2024-01-19 Update year; Add ESP port link; Add DMA trickery hint.
2024-01-30 UNFINISHED Linux compatibility mode via DMA.
2024-01-30 Add UNTESTED DMA pause & resume functions & functionality of is-busy function.
2024-01-30 UNTESTED fix of send control blocks function.
    [main.c]
2024-01-31 Bugfix: Use ACTIVE instead of END flag for is-busy check.
    [dma.c]
2024-01-31 Rename to avoid conflict; Add bcm_host library; "Fix" order of parameters.
    [dma.c, dma_gpio.c, dma_gpio.h, dma_gpio_func.h, gpio.h]
2024-01-31 Bugfixes and to-do comment.
    [main.c]
2024-02-01 Bugfixes: PWM range divided by 2; Set .next_cb_addr of last CBs to 0; Use correct CB offsets.
    [main.c]
2024-02-01 Replace void pointer arithmetic and hard-coded stuff.
    [dma.c]
2024-02-01 Bugfix: PWM frequency and divisor.
    [main.c]
2024-02-01 Bugfix: Now WORKING with CBM3032 and BASIC v4!
    [main.c]
2024-02-03 Replace to-do by removing optional file path (untested); Comment.
    [main.c]
2024-02-03 Replace second file-name to-do comment with removal of path part.
    [main.c]
2024-02-03 Replace to-dos with useful PRG names; Fix commandline parameters.
    [main.c]
2024-02-03 Replace to-do/hard-coded by counting the max. byte count necessary and logging it (untested).
    [main.c]
2024-02-04 Fix/improve header CBS transfer progress bar.
    [main.c]
2024-02-04 Stop transfer, if motor is off within the last transmit block gap.
2024-02-05 Set SENSE line back to HIGH at CBM; Correctly finish send_cbs() (set READ line back to HIGH at CBM); Improve & add some comments.
    [main.c]
2024-02-05 Improve error handling and deinitialization.
    [main.c]
2024-02-09 Fix "infrastructure" (still too complicated).
    [main.c]
2024-02-10 Comment-out currently not used stuff.
2024-02-12 Dirty bugfix with to-do comments (improve this).
    [petload.c]
2024-02-17 Improve Linux port "bugfix" a bit.
    [petload.c]
2024-02-18 Improve file system "infrastructure"; Some bug fixes.
    [cmd.c, config.h, main.c]
2024-02-18 Bugfix: Add memcpy() reference for Linux port.
    [cmd.c]
2024-02-18 Entirely remove mount() for Linux port.
2024-02-21 Get Pi out of wait loop after cmd. failed; Improve to-do comment.
    [main.c]
2024-03-02 Replace to-do with PETSCII to ASCII conversion.
    [ui_commodore_to_terminal.c]
2024-03-02 Replace to-do comment with ASCII to PETSCII conversion.
    [main.c]
2024-03-03 Re-add hints about loading gpio-no-irq overlay (unfortunately still necessary); Add C64 note & bugs hint to README file.
    [main.c]
2024-03-03 Replace printf() (more or less cosmetic).
    [main.c]
2024-03-04 Bugfix: Slow-down tape emulation for (e.g.) C64.
    [main.c]
